marcotayar/manipulator_ws/README.md

# manipulator_ws

ROS 2 Humble workspace for a 4-DOF RRRR desktop manipulator controlled via an ESP32 (micro-ROS).

## Robot overview

| Joint | Type | Axis | Range | Hardware |
|---|---|---|---|---|
| J1 — base yaw | Continuous | Z | velocity-only (no position limit) | 360° servo |
| J2 — shoulder | Revolute | Y | ±90° | Standard servo |
| J3 — elbow | Revolute | Y | ±90° | Standard servo |
| J4 — wrist | Revolute | Y | ±90° | MG90S servo |
| Gripper | Prismatic (×2) | Y | 0–13 mm | Servo |

**Link geometry** (matches `arm_ik_2d.py`):

```
Shoulder origin:  0.09 m above ground  (base 0.07 m + turntable 0.02 m)
L1  shoulder → elbow:  0.10 m
L2  elbow → wrist:     0.09 m
L3  wrist → EE tip:    0.15 m  (gripper_base 0.03 m + fingers 0.12 m)
```

## Screenshots

| RViz simulation — 45° base yaw | Qt hardware control panel |
|:---:|:---:|
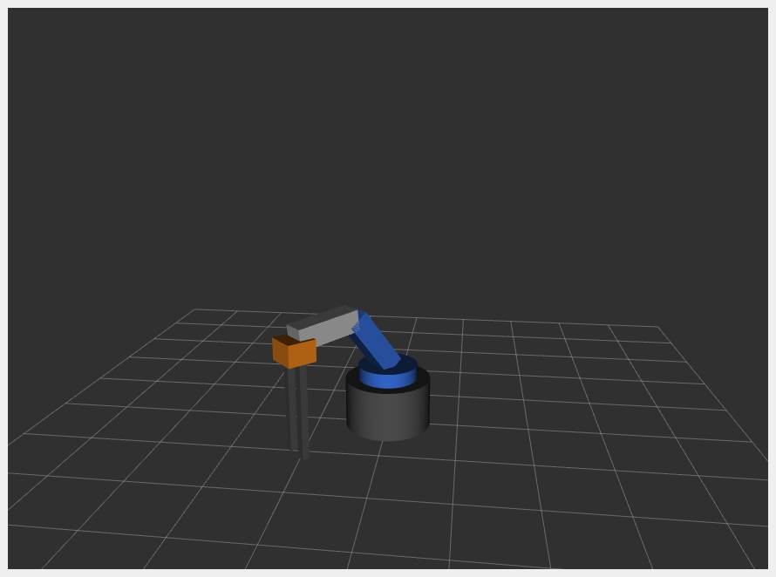
[picture p1: docs/images/rviz_simulation.png]
RRRR manipulator in RViz
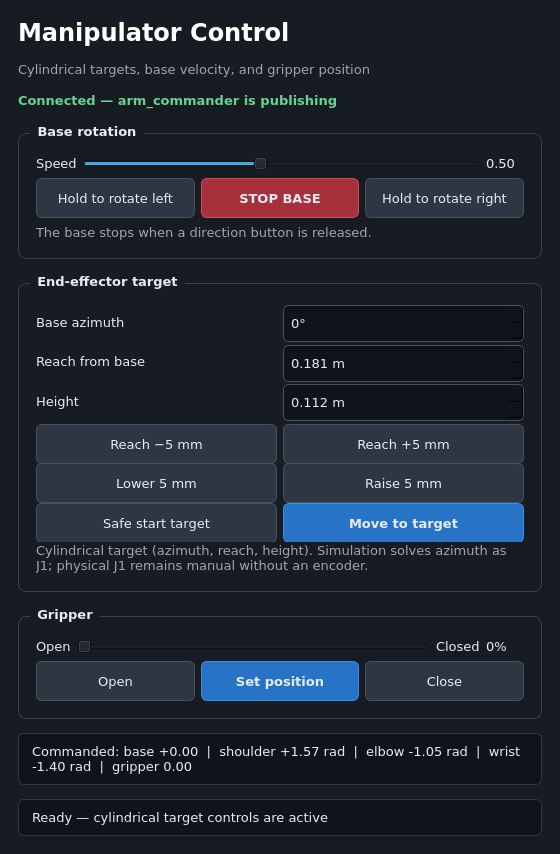
[picture p2: docs/images/qt_control_panel.png]
Qt manipulator control panel
|  |  |

## Packages

| Package | Type | Purpose |
|---|---|---|
| `manipulator_description` | ament_cmake | URDF/xacro, RViz config |
| `manipulator_control` | ament_python | Keyboard teleop, click-to-target, arm commander, 2D IK |
| `manipulator_kinematics` | ament_python | 3D IK node with TF-based trajectory visualization |

## Prerequisites

- **ROS 2 Humble**
- **setuptools 58.2.0** — required for colcon to build `ament_python` packages (newer versions dropped `setup.py develop --editable`):

```bash
pip3 install setuptools==58.2.0
```

- Standard ROS tools (already in a desktop install):

```bash
sudo apt install ros-humble-joint-state-publisher-gui \
                 ros-humble-robot-state-publisher \
                 ros-humble-rviz2 \
                 ros-humble-xacro \
                 ros-humble-tf2-ros \
                 ros-humble-joy \
                 python3-pyqt5
```

`ros-humble-joy` is only needed if you are using a gamepad.
`python3-matplotlib` and `python3-numpy` are optional dependencies for
regenerating the workspace plot.

## Build

```bash
cd ~/manipulator_ws
source /opt/ros/humble/setup.bash
colcon build --symlink-install
source install/setup.bash
```

Add the source line to your shell if you don't want to run it each session:

```bash
echo "source ~/manipulator_ws/install/setup.bash" >> ~/.bashrc
```

## Usage modes

### 1. Visualize only (joint sliders)

Shows the robot in RViz with a GUI slider for every joint. Useful for checking the model.

```bash
source /opt/ros/humble/setup.bash
source install/setup.bash
ros2 launch manipulator_description display.launch.py
```

### 2. Keyboard teleop

Opens RViz and lets you drive each joint from the keyboard. Run the launch file in one terminal and the teleop node in a second terminal (it requires raw key input on its own TTY).

**Terminal 1:**
```bash
ros2 launch manipulator_control teleop.launch.py
```

**Terminal 2:**
```bash
ros2 run manipulator_control keyboard_teleop
```

Key bindings:

| Key | Action |
|---|---|
| `q` / `a` | base spin left / right (velocity, keeps spinning) |
| `space` | base stop |
| `w` / `s` | J2 shoulder +/− |
| `e` / `d` | J3 elbow +/− |
| `r` / `f` | J4 wrist +/− |
| `t` / `g` | gripper close / open |
| `z` | home (all joints to 0, base stops) |
| `x` | quit |

J1 is velocity-controlled: press `q` or `a` to start spinning, `space` to stop. J2–J4 step 0.05 rad (~3°) per keypress; gripper steps 2 mm.

### 3. Click-to-move (IK)

Click anywhere in the RViz viewport to send the arm to that position using the IK solver. The EE trajectory is drawn as an orange line.

```bash
ros2 launch manipulator_control click_move.launch.py
```

In RViz, select the **Publish Point** tool from the top toolbar, then click on the ground grid. The IK node smoothly interpolates the arm to the target over ~1.5 s and reports the final position error in the terminal.

### 4. Base + gripper teleop (separate node)

Velocity control for the continuous-rotation base servo and direct gripper control:

```bash
ros2 run manipulator_control base_gripper_teleop
```

| Key | Action |
|---|---|
| `j` | base rotate left |
| `l` | base rotate right |
| `k` | base stop |
| `o` | gripper open |
| `p` | gripper close |
| `x` | quit |

### 5. Real hardware (joystick + click-to-target)

See [Hardware control](#hardware-control) below.

### 6. Qt panel (real hardware) and RViz simulation

```bash
ros2 launch manipulator_control sim.launch.py             # test IK in RViz, kinematic plant
ros2 launch manipulator_control sim.launch.py plant:=pid  # closed-loop PID plant (section 7)
ros2 launch manipulator_control hardware.launch.py        # Qt panel for full_arm_controller
```

The simulation launches start RViz, click-to-target and `arm_commander`. The Qt
panel (`arm_control_gui`) is hardware-only: it talks to `full_arm_controller`
over `/arm_joint_targets_deg`, `/arm_pid_enable`, `/arm_pid_gains`,
`/arm_joint_telemetry` and `/estop`.

- **Tuning tab:** per-joint enable, target slider, Kp/Ki/Kd/G (sent only while
  every joint is disabled; defaults mirror the firmware), and live plots of
  angle, target and motor duty. Fault code and joint are shown in the header.
- **Inverse kinematics tab:** click the side view to set a goal for the gripper
  tip; the tip angle is chosen automatically or set with the slider. With all
  three joints enabled, **Move along straight line** streams intermediate IK
  solutions at 20 Hz (3 cm/s, every joint capped at 6°/s, under the firmware's
  8°/s ramp). If the straight line would cross a joint limit, the move finishes
  in joint space and the panel says so.
- **Safety:** targets are seeded from the first telemetry sample and disabled
  joints keep tracking their measured angle, so enabling never jumps.
  **Park at 90° & disable** brings every enabled joint to vertical before
  cutting power (a disabled joint far from vertical falls); **Disable now** cuts
  power immediately.

Kinematics (`arm_kinematics.py`) use the firmware's physical degrees: 90° is a
link straight up, larger angles lean outward, and each joint's lean adds to the
links before it. Targets are limited to 85–175° (wrist 85–170°).

For calibrated shoulder feedback and isolated shoulder PID control, use
`shoulder_pot_feedback/shoulder_pot_feedback.ino`.
Copy `shoulder_pot_feedback/wifi_config.example.h` to `wifi_config.h` in that
directory, then set the Wi-Fi credentials and `AGENT_IP` to the computer's current
Wi-Fi IPv4 address. `wifi_config.h` is ignored by Git; never commit credentials.
The address can change after reconnecting to a hotspot. Keep the micro-ROS agent
running on UDP port 8888. Check `ros2 topic hz /shoulder_feedback`: expect about
20 Hz. The potentiometer wiper must reach GPIO34 through a suitable voltage
divider, with a shared ground; never exceed the ESP32 ADC input voltage.
The installed divider uses the measured descending-sweep calibration below.
Firmware interpolates between adjacent anchors and clamps feedback to 0–75°.

| Shoulder angle from horizontal | Raw ADC median |
|---|---|
| 0° | 2319 |
| 15° | 2525 |
| 30° | 2687 |
| 45° | 2874 |
| 60° | 3037 |
| 75° | 3100 |

At 90° the raw median was 3101, indistinguishable from 75° within measured noise.
Consequently, feedback cannot identify motion above 75°; 75° is a saturation
value, not proof of the physical angle. Sensitivity is lower near the upper end.
An ascending 45° check gave ADC 2865 (44.28° with this mapping). This is a held-point
calibration, not an independently validated full-travel accuracy specification.
Recalibrate `SHOULDER_CALIBRATION` after changing the divider or wiring, using
`CALIBRATE_MODE 1` to read raw ADC over USB at 115200 baud.
Measured shoulder feedback is displayed without the commanded-motion 10° lower
limit; command limits are unchanged.

#### Full-arm H-bridge wiring and calibration

`docs/ligacao_pontes_h_esp32.pdf` shows the original two-TB6612 layout; the arm
is now wired as below (verified by single-joint motor tests):

| Joint | Driver channel | PWM | IN1 | IN2 | Potentiometer | `direction` |
|---|---|---:|---:|---:|---:|---:|
| Shoulder | TB6612 #1 A | GPIO19 | GPIO18 | GPIO5 | GPIO34 | +1 |
| Base (DC motor, no feedback) | TB6612 #1 B | GPIO17 | GPIO16 | GPIO15 | — | held LOW |
| Elbow | TB6612 #2 A | GPIO23 | GPIO22 | GPIO21 | GPIO39 | −1 |
| Wrist | TB6612 #2 B | GPIO32 | GPIO14 | GPIO13 | GPIO36 | +1 |
| Gripper, positional servo | Direct servo signal | GPIO26 | — | — | — | — |

The base motor is not controlled yet: firmware drives GPIO17/16/15 LOW from boot.

GPIO4 drives both TB6612 STBY inputs wired together. Both bridges use ESP32
3V3 for logic VCC, an external motor-rated VM supply, and a common ground.
GPIO34, GPIO36, and GPIO39 are ADC1 input-only pins and remain usable while
Wi-Fi is active. Each potentiometer is supplied from ESP32 3V3 with a common
ground, and its wiper connects directly to its ADC pin.
GPIO5 and GPIO15 are ESP32 strapping pins; if the ESP32 does not boot reliably,
disconnect those driver inputs before power-up and move them in both the wiring
and firmware before deployment.

`full_arm_controller/full_arm_controller.ino` is the full-arm controller for this
wiring: position PID for shoulder, elbow, and wrist plus base and gripper servo
outputs. Copy `wifi_config.example.h` to `wifi_config.h` in that directory (ignored
by Git) and set `AGENT_IP` to the computer's address on the same 2.4 GHz network.
The ESP32 cannot join WPA2-Enterprise networks such as eduroam.

```bash
docker run --rm --net=host microros/micro-ros-agent:humble udp4 --port 8888
arduino-cli compile --fqbn esp32:esp32:esp32 full_arm_controller
```

Joint angles are **physical** degrees with 90° as the home pose (arm vertical),
not the `arm_ik_2d.py` frame. Commands are limited to 85–175°.

> **The arm falls on any fault or disable.** Every fault (stale target,
> invalid feedback, stall, runaway, e-stop) and every ordinary disable
> short-brakes all motors (TB6612 IN1 = IN2 = HIGH). Braking slows a falling
> link but the motors cannot hold position unpowered:
> the shoulder sagged from 110° and then fell past its 180° stop, saturating
> GPIO34 (above 3.3 V). Keep the arm mechanically supported whenever it is away
> from vertical, and bring joints back near 90° before disabling.

| Topic | Type | Meaning |
|---|---|---|
| `/arm_joint_targets_deg` | `std_msgs/Float32MultiArray` | Exactly `[shoulder, elbow, wrist]`, 85–175°, refreshed within 1 s |
| `/arm_pid_enable` | `std_msgs/Int32` | Bitmask: 1 shoulder, 2 elbow, 4 wrist; 0 disables all; boots disabled |
| `/arm_pid_gains` | `std_msgs/Float32MultiArray` | 15 values `[Kp,Ki,Kd,G,F]` × shoulder/elbow/wrist; only while all disabled. `G` = gravity feedforward, 0–80% duty with the link horizontal. `F` = friction feedforward, 0–40% duty in the direction the setpoint moves (full at 2°/s, zero at rest); defaults 10/12/10. The 1.5° deadband applies only after the target has been still for 0.3 s |
| `/estop` | `std_msgs/Bool` | Transient-local; true disables all joints |
| `/arm_command` | `std_msgs/Float32MultiArray` | Only `[4]` gripper is used |
| `/arm_joint_telemetry` | `std_msgs/Float32MultiArray` | 20 Hz, 16 values (below) |

Telemetry: `[shoulder_deg, elbow_deg, wrist_deg, shoulder_raw, elbow_raw,
wrist_raw, shoulder_target, elbow_target, wrist_target, shoulder_duty,
elbow_duty, wrist_duty, enabled_mask, fault_code, fault_joint, estop]`. Angles are
−1 outside the calibration table. Fault codes: 0 none, 1 invalid/stale target,
2 feedback invalid or outside 80–178°, 3 control timeout, 4 e-stop, 5 runaway
(joint moved more than 4° opposite to the applied push, away from its commanded
target, and is more than 6° (shoulder, elbow) or 10° (wrist) from it, confirmed on two consecutive 20 Hz control
samples; a joint carried toward its target while the controller brakes is fine).
Zero output does not reset the direction reference; a genuine reversal does.
On a runaway fault, USB serial records the triggering raw ADC, measured angle,
target, ramp setpoint, output and reference after braking all joints.
6 stall (output at
the duty cap for 1 s with under 1° of motion; protects the TB6612). Any fault
disables every joint. Targets are followed through an internal 8°/s ramp that
stays within 6° of the measured angle, so large target jumps do not slam the
joint. Output is capped at 80% duty; the 1 s stall cutout limits time at the cap.
Inside the 1.5°
deadband the controller stops correcting but keeps applying its frozen integral,
so gravity-loaded joints hold instead of falling. Control runs in a dedicated
20 Hz FreeRTOS task, independent of Wi-Fi/micro-ROS stalls.

**Gravity compensation:** each joint adds `-G · sin(lean)` duty, where `lean` is
the sum of `(angle − 90°)` from the shoulder out to that joint (how far its
distal links lean from vertical). This assumes all three joints increase their
angle in the same rotational sense. A joint gets no feedforward if any reading
from the shoulder out to it is invalid. Defaults come from powered holds at 135°
(G = hold duty minus the P correction, over sin(lean)): shoulder 33, elbow 28
(held 137.0° with 0.02° drift over 8 s), wrist 25. The wrist needs its term once
the shoulder leans; with `G = 0` it was dragged outward during a shoulder move.
The prebuilt micro-ROS library allows at most 5 subscriptions, so `G` shares the
gains message instead of having its own topic.

**Commissioning results:** all three directions are verified. Shoulder (Kp 2.0,
Ki 0.3) and wrist (Kp 4.0, Ki 1.0) reach a 5° step; both need about 10–22% duty
to break static friction and stick about 2° past the target. The elbow (Kp 4.0,
Ki 1.0) did not move at all at the 50% cap (stall). Do not raise its cap: MG996R stall
current exceeds the TB6612's 1.2 A continuous rating. Check VM under load and
the elbow's mechanical load first. Enable one joint at a time.

```bash
ros2 topic pub --rate 10 /arm_joint_targets_deg std_msgs/msg/Float32MultiArray "{data: [90.0, 90.0, 90.0]}"
ros2 topic pub --once /arm_pid_enable std_msgs/msg/Int32 "{data: 1}"   # shoulder only
ros2 topic pub --once /arm_pid_enable std_msgs/msg/Int32 "{data: 0}"   # disable all
```

Calibration tables (`full_arm_controller/*_calibration_*.csv`) belong only to the
current potentiometers, ADC pins, mounting, and direct-wiper wiring. Shoulder
values are midpoints of ascending and descending passes; expect about ±3°
(direction-dependent play). Set `CALIBRATE_MODE 1` to print raw ADC CSV over USB
with every actuator disabled and Wi-Fi off. Never copy one joint's table to
another or reuse it after rewiring.

#### Shoulder PID position control (TB6612FNG HW166)
> **Legacy shoulder-only wiring:** this section documents the previously tested
> standalone shoulder setup. Its GPIO32/14/13/25/26/27 outputs conflict with the
> updated full-arm wiring above. Do not flash `shoulder_pot_feedback.ino` while
> the two bridges are wired according to `ligacao_pontes_h_esp32.pdf`.

The shoulder is a two-wire DC motor driven by channel B, not a PWM-position servo.
The standalone sketch retains GPIO34 potentiometer feedback.

| Driver terminal | Connection |
|---|---|
| PWMB | ESP32 GPIO32 |
| BIN1 / BIN2 | ESP32 GPIO14 / GPIO13 |
| STBY | ESP32 GPIO25 |
| AIN1 / AIN2 | ESP32 GPIO26 / GPIO27 (held low; channel A unused) |
| BO1 / BO2 | Shoulder motor leads |
| VCC | ESP32 3V3 (logic supply) |
| VM | Motor's rated external supply |
| GND | ESP32 GND and external supply negative |

VCC is separate from VM. At 5 V logic supply, the driver's guaranteed input-high
threshold exceeds the ESP32's 3.3 V output; use 3.3 V for VCC. Check the motor's
stall current against the driver/module rating before powering it.
See the [TB6612FNG datasheet](https://www.pololu.com/file/0J86/TB6612FNG.pdf).

`shoulder_pot_feedback/shoulder_pot_feedback.ino` runs a 20 Hz position PID on
the ESP32 using the measured potentiometer calibration. Positive duty raises
the shoulder; negative duty lowers it. Channel B uses 20 kHz PWM.
The open-loop duty topic is removed: the PC sends a position target, not power.

| Topic | Type | Meaning |
|---|---|---|
| `/shoulder_target_deg` | `std_msgs/Float32` | Finite target in degrees from horizontal, 5–70° |
| `/shoulder_pid_enable` | `std_msgs/Bool` | Explicit enable/disable; disabled at boot |
| `/shoulder_feedback` | `std_msgs/Float32` | Measured angle in radians, unchanged |
| `/estop` | `std_msgs/Bool` | Transient-local safety subscription; true disables PID |
| `/shoulder_pid_gains` | `std_msgs/Float32MultiArray` | Exactly `[Kp, Ki, Kd]`; accepted only disabled and not estopped |
| `/shoulder_pid_telemetry` | `std_msgs/Float32MultiArray` | Firmware diagnostics at 20 Hz; schema below |

Targets must be refreshed within 1 second. Enabling requires a fresh valid target
and a valid measurement less than 150 ms old. Invalid targets, out-of-calibration
ADC readings, measured angles outside 5–70°, stale targets/control updates, and
initialization errors disable PID and enter standby. E-stop release never
re-enables it: send a fresh target and explicitly enable again.
These are software checks, not a hardware safety cutoff; standby coasts and
does **not** hold the arm against gravity. Keep the arm supported and motor power
accessible during commissioning. Sensor saturation above 75° is not recoverable.

Initial, **not hardware-tuned**, gains are `PID_KP=0.6`, `PID_KI=0.1`,
`PID_KD=0.04`, with degrees as the error unit and duty percent as the output unit.
Output is limited to ±15%. The controller uses measured elapsed time,
derivative on measurement with a 0.1 s velocity low-pass filter, and conditional
integration anti-windup. No minimum-duty kick or gravity compensation is assumed.
It may respond slowly, stall or oscillate until tuned for the actual load.

**Graphical tuning:** the Qt panel (`hardware.launch.py`) drives
`full_arm_controller`, not this single-joint sketch. Tune this sketch with the
topics above.

Gain ranges are Kp 0–5, Ki 0–2, Kd 0–1 (finite values only). The ±15% output
limit is not raised by gain changes. Live tuning means monitoring the response
and adjusting gains between disabled runs, not changing gains during motion.

Telemetry has exactly 14 values:
`[target_deg, measured_deg, error_deg, P_duty, I_duty, D_duty, output_duty,
enabled, estop, Kp, Ki, Kd, max_duty, fault_code]`.
Duty quantities are percentages; enabled/estop are 0 or 1. Fault codes:
0 none, 1 invalid/stale target, 2 invalid/out-of-safe-range feedback,
3 control timeout, 4 emergency stop. Disabled output and P/I/D terms are zero.

Build only (does not upload or move hardware):

```bash
arduino-cli compile --fqbn esp32:esp32:esp32 shoulder_pot_feedback
```

After a separate, supervised upload/commissioning step, start a continuous target
publisher at the arm's current safe measured angle. Example for an arm at 45°:

```bash
ros2 topic pub --rate 10 /shoulder_target_deg std_msgs/msg/Float32 "{data: 45.0}"
```

In another terminal, explicitly enable:

```bash
ros2 topic pub --once /shoulder_pid_enable std_msgs/msg/Bool "{data: true}"
```

Disable while continuing to support the arm:

```bash
ros2 topic pub --once /shoulder_pid_enable std_msgs/msg/Bool "{data: false}"
```

Stopping the target publisher also disables control after the one-second timeout.
The panel's existing IK position controls and `/arm_command` do not feed this
isolated shoulder controller; use its Shoulder PID tab or the direct topics.
The panel's `/estop` also disables the shoulder PID. The all-servo
`esp32_microros.ino` is a different hardware configuration and must not be flashed
on this TB6612 wiring: its output pins conflict with the driver connections.

**Emergency stop.** The red button publishes a latched `/estop`
(`std_msgs/Bool`). While engaged, `arm_commander` and `ik_node` stop the base,
freeze the arm at its last command and ignore new targets, base and gripper
commands; the panel's controls are disabled. Click again to release. It stops
only what goes through these nodes; it does not cut servo power.

Hold a base direction button to rotate; releasing it sends a stop command.
The reach/height jog buttons move in 5 mm steps, and invalid targets are
rejected in the panel. The status line turns green when `/arm_command`
feedback is being received from `arm_commander`.

Analysis window (read-only, run next to either launch):

```bash
ros2 launch manipulator_control analysis.launch.py
```

It plots tracking error (command − measured, per joint) and the gripper and
base signals, with pause/resume, clear, a 10/20/60 s window and CSV export of
the full recording (up to one hour). Without an elbow/wrist sensor on hardware
only the shoulder error is available.

### 7. Closed-loop PID numerical simulation

`sim.launch.py plant:=pid` runs the same panel and `/arm_command`
interface as deployment, but replaces
the ESP32/servos with a 200 Hz numerical plant. J2-J4 use position PID with
gravity feedforward; J1 uses velocity PID; the gripper uses position PID.
`/joint_states` contains simulated encoder measurements, not copied commands.

Desired state is published on `/joint_setpoint`. `/pid_diagnostics` contains
five errors followed by five controller efforts. Publish five additive efforts
to `/sim_disturbance` to test rejection, then publish zeros to remove them:

```bash
ros2 topic pub -1 /sim_disturbance std_msgs/msg/Float32MultiArray \
  "{data: [0.0, 0.25, 0.0, 0.0, 0.0]}"
ros2 topic pub -1 /sim_disturbance std_msgs/msg/Float32MultiArray \
  "{data: [0.0, 0.0, 0.0, 0.0, 0.0]}"
```

The inertia, damping, and PID gains in `pid_sim_node.py` are nominal simulation
parameters. Identify the real plant after installing encoders before reusing
those gains on hardware.

## ROS topics

| Topic | Type | Publisher | Subscriber |
|---|---|---|---|
| `/joint_states` | `sensor_msgs/JointState` | `keyboard_teleop`, `ik_node`, or `pid_sim` | `robot_state_publisher` |
| `/joint_setpoint` | `sensor_msgs/JointState` | `pid_sim` | diagnostics/plots |
| `/target_pose` | `geometry_msgs/Point` | `click_to_target`, `joy_to_arm` | `ik_node`, `arm_commander` |
| `/base_cmd` | `std_msgs/Float32` | `joy_to_arm`, `base_vel_gui`, `base_gripper_teleop`, `keyboard_teleop` | `arm_commander`, `ik_node` |
| `/gripper_cmd` | `std_msgs/Float32` | `joy_to_arm`, `base_gripper_teleop` | `arm_commander`, `ik_node` |
| `/estop` | `std_msgs/Bool` (latched) | `arm_control_gui` | `arm_commander`, `ik_node`, `full_arm_controller` |
| `/joy` | `sensor_msgs/Joy` | `joy_node` | `joy_to_arm` |
| `/arm_command` | `std_msgs/Float32MultiArray` | `arm_commander` | ESP32 (micro-ROS), `pid_sim` |
| `/pid_diagnostics` | `std_msgs/Float32MultiArray` | `pid_sim` | diagnostics/plots |
| `/sim_disturbance` | `std_msgs/Float32MultiArray` | test/operator | `pid_sim` |
| `/clicked_point` | `geometry_msgs/PointStamped` | RViz | `click_to_target` |
| `/click_marker` | `visualization_msgs/Marker` | `click_to_target` | RViz |
| `/ee_trajectory` | `visualization_msgs/Marker` | `ik_node` | RViz |

### `/arm_command` payload

Five floats sent to the ESP32 at 50 Hz:

```
[0]  base_velocity   -1.0 .. +1.0
[1]  shoulder_angle  rad
[2]  elbow_angle     rad
[3]  wrist_angle     rad
[4]  gripper         0.0 open .. 1.0 closed
```

The base joint uses velocity (not position) because the hardware is a continuous-rotation servo with no angle feedback.

### Action space and workspace

The physical command action is:

| Index | Action | Range |
|---:|---|---|
| 0 | Base velocity | −1.0 to +1.0 normalized |
| 1 | Shoulder angle | +0.175 to +1.571 rad (10° to 90°) |
| 2 | Elbow angle | −1.396 to +1.396 rad (−80° to 80°) |
| 3 | Wrist angle | −1.396 to +1.396 rad (−80° to 80°) |
| 4 | Gripper position | 0.0 open to 1.0 closed |

`arm_commander` prints these ranges at startup. The plot below samples the
joint limits, filters out points below ground, and revolves the planar set
through the continuous base yaw. It does not model self-collision or payload.

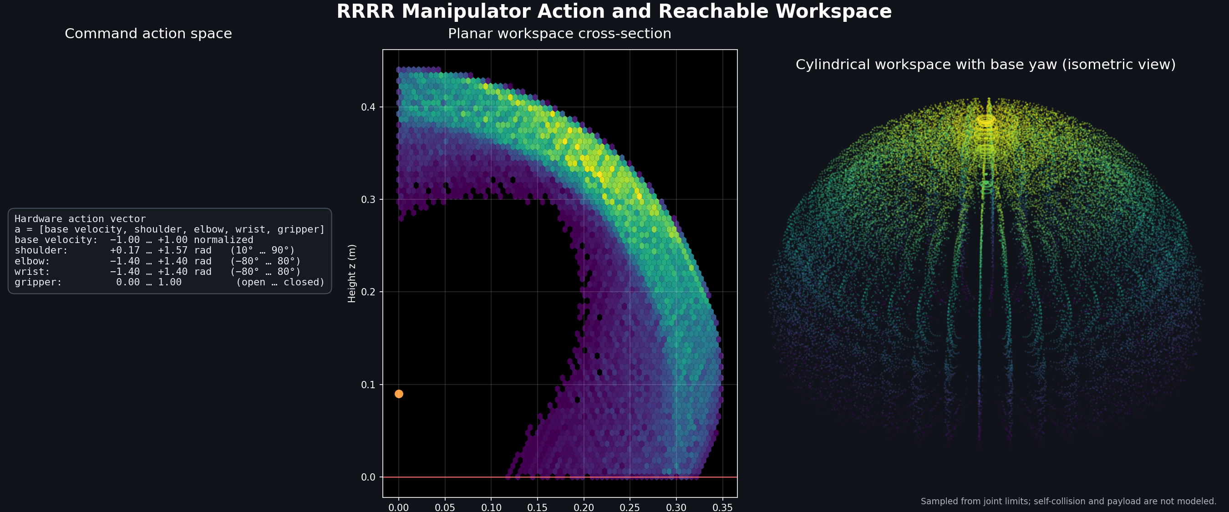
[picture p3: docs/images/action_space.png]
Manipulator action and reachable workspace


Regenerate the plot with:

```bash
python3 src/manipulator_control/scripts/plot_action_space.py
```

## IK solvers

Two independent IK implementations are included:

**`arm_ik_2d.py`** (used by `arm_commander`) — cylindrical decomposition plus
2D geometric IK in the vertical arm plane. It converts a Cartesian target with
`yaw = atan2(y, x)` and `reach = sqrt(x² + y²)`, then solves shoulder, elbow,
and wrist. It prefers the EE pointing straight down and searches other
orientations in 1° steps when necessary.

**`ik_node.py`** (used by `click_move.launch.py`) — full cylindrical IK for the
simulation. It commands J1 to the solved yaw, interpolates all four joints over
50 steps, and reads the EE position from TF for trajectory drawing.

#### Why hardware base yaw remains manual

The cylindrical solver returns an absolute base yaw, and the URDF simulation
uses it directly. The physical J1 is a 360° continuous-rotation servo: it only
accepts speed and has no encoder, so the software cannot know its current angle
or close the loop on a desired yaw. The Qt azimuth field is therefore a target
reference for hardware while the operator aligns J1 with the hold buttons.

For true four-joint hardware IK, replace J1 with a positional servo or add an
absolute encoder. Then `/arm_command[0]` can carry base yaw instead of velocity
and the firmware can close the position loop.

## Hardware control

The gamepad connects to the **PC** (USB or Bluetooth), not to the ESP32. The ESP32 only runs a lightweight micro-ROS subscriber and drives the servos.

```
Gamepad ──(USB/BT)──▶ PC
                       ├─ joy_node      → /joy
                       ├─ joy_to_arm    → /base_cmd, /target_pose, /gripper_cmd
                       └─ arm_commander → /arm_command ──(WiFi)──▶ ESP32 servos
```

Arduino libraries required: **ESP32Servo**, **micro_ros_arduino** (Humble branch).

---

### One-time firmware setup

**1. Fill in your network details** at the top of `esp32_microros.ino`:

```cpp
#define WIFI_SSID   "your-network"
#define WIFI_PASS   "your-password"
#define AGENT_IP    "192.168.x.x"   // run: hostname -I | awk '{print $1}'
#define AGENT_PORT  8888
```

**2. Flash** via Arduino IDE (board: *ESP32 Dev Module*, partition scheme: *Huge APP (3MB No OTA)*, upload speed: 921600).

**3. Verify servo zero positions** — at startup all servos receive 1500 µs (center pulse). The arm should sit with each link pointing **horizontal** (shoulder/elbow/wrist all at 0 rad in `arm_ik_2d` convention). If a link points the wrong way, rotate the servo horn one spline and reflash.

---

### Every session

**Terminal 1 — micro-ROS agent** (keep running):

```bash
docker run -it --rm --net=host microros/micro-ros-agent:humble udp4 --port 8888
```

Wait for `[1] [RTPS Participant matched]` — confirms the ESP32 connected.

**Terminal 2 — joystick driver:**

```bash
ros2 run joy joy_node
```

Plug in or pair your gamepad before running this. Verify it works with `ros2 topic echo /joy`.

**Terminal 3 — joy_to_arm translator:**

```bash
source ~/manipulator_ws/install/setup.bash
ros2 run manipulator_control joy_to_arm
```

**Terminal 4 — arm_commander** (IK + hardware bridge):

```bash
ros2 run manipulator_control arm_commander
```

---

### Gamepad button mapping

| Input | Action |
|---|---|
| **L1** | Base rotate left |
| **R1** | Base rotate right |
| **D-pad ↑ / ↓** | EE height +/− 5 mm |
| **D-pad → / ←** | EE reach +/− 5 mm |
| **△ / Y** | Gripper open |
| **□ / X** | Gripper close |

Default indices are set for **PS3/PS4 on Linux**. If your controller maps differently, run `ros2 topic echo /joy` while pressing buttons to find the right indices, then edit the constants at the top of [joy_to_arm.py](src/manipulator_control/manipulator_control/joy_to_arm.py).

**Reachable workspace** (ground-level targets, with wrist orientation allowed
to tilt when straight-down is unavailable):

```
approximately 0.120 m ≤ reach from base axis ≤ 0.324 m
```

The UI input bounds are intentionally broader; the IK solver validates every
reach/height pair and rejects targets outside the actual joint-limited region.

---

### Failsafe behaviour

| Condition | Response |
|---|---|
| `/arm_command` silent for > 1 s | Base servo stops; position servos hold last angle |
| micro-ROS agent unreachable for > 5 s | ESP32 reboots and reconnects automatically |

> **Note:** RViz shows the URDF at its home pose and does not mirror the real arm. `arm_commander` does not publish `/joint_states`.

---

### Calibration

**Joystick feel** — edit constants at the top of [joy_to_arm.py](src/manipulator_control/manipulator_control/joy_to_arm.py):

| Constant | Default | Adjust when… |
|---|---|---|
| `STEP` | 0.005 m | D-pad steps feel too coarse or too fine |
| `BASE_SPEED` | 0.5 rad/s | Base rotates too fast or too slow |

**Servo tuning** — edit constants at the top of `esp32_microros.ino`:

| Constant | Default | Adjust when… |
|---|---|---|
| `BASE_SPEED_RANGE` | 200 µs | Base doesn't reach the speed set by `BASE_SPEED` |
| `GRIP_OPEN_DEG` | 80° | Gripper does not open to the desired position |
| `GRIP_CLOSED_DEG` | 140° | Gripper does not close to the desired position |
| `SERVO_MIN_US` / `SERVO_MAX_US` | 500 / 2500 µs | Positional servo travel is compressed or reaches its mechanical stop |
