marcotayar/manipulator_ws/docs/manipulator_modeling_pid.pdf

## Mathematical Modeling and Closed-Loop PID Control

Four-DOF RRRR Desktop Manipulator with Positional Gripper

ROS 2 Humble implementation: manipulator_ws

September 2026

Abstract

This document derives the kinematic and numerical dynamic models implemented in the ROS 2 workspace, then derives the discrete PID controllers used by the closed-loop simulator. It distinguishes model parameters from experimentally identified hardware data, defines every coordinate conversion and ROS interface, and gives a direct path from simulated encoder feedback to encoder-based hardware deployment. The implementation referenced throughout is the PID simulation node; geometry and inverse kinematics are shared with the manipulator control package.

Scope. The current closed-loop simulator is a deliberately compact numerical plant, not a full multibody or finite-element model. It includes nominal inertia, viscous damping, gravity, effort saturation, hard stops, disturbances, and simulated encoder states. Parameters marked nominal must be identified on the real arm before gains are transferred to hardware.

### Contents

1 Robot definition | 2
2 Coordinate conventions and forward kinematics | 3
3 Inverse kinematics | 4
4 Numerical dynamic plant | 4
5 PID controller derivation | 5

RRRR Manipulator | Mathematical Model and PID Control
6 Closed-loop interpretation | 7
7 ROS 2 signal model | 7
8 Numerical validation results | 7
9 Encoder-based hardware deployment | 8
10 Model limitations and interpretation | 9
11 Source-to-equation traceability | 10

### 1 Robot definition

### 1.1 Generalized coordinates

The robot has one base-yaw joint and three serial pitch joints:

q =

h
q1 | q2 | q3 | q4

iT

The URDF convention used by the numerical plant is:

- q1: rotation about world +z; continuous.
- q2, q3, q4: rotation about each local +y axis.
- At q2 = q3 = q4 = 0, all arm links point along +z.
- Positive pitch rotates a link from +z toward the radial +x direction.

The gripper has two mirrored prismatic joints. Both receive the same joint coordinate; opposite URDF axis vectors create symmetric finger motion.

### 1.2 Geometry

Table 1: Geometry used by URDF, FK, IK, and PID simulation.
Symbol Meaning | Value
h0 | shoulder height above ground | 0.090 m
L1 | shoulder to elbow | 0.100 m
L2 | elbow to wrist | 0.090 m
L3 | wrist to end-effector tip | 0.160 m
rb | base radius | 0.060 m
hb | base-cylinder height | 0.070 m
wl
, dl | link cross-section | 0.030 × 0.030 m
sf | finger travel per side | 0.030 m

The nominal geometric reach is
| L1 + L2 + L3 = 0.350 m,

but the usable workspace is smaller and non-convex because of joint limits, ground clearance, and end-effector orientation feasibility.

### 1.3 Masses and URDF inertias

Component | Mass (kg)
Base | 0.150
Turntable | 0.030
Link 1 | 0.095
Link 2 | 0.095
Gripper parameter | 0.080
Each finger | 0.010

For a uniform box of side lengths (a, b, c), the URDF uses

Ixx =

m
(b

2 + c

2
), Iyy =

m
(a

2 + c

2
), Izz =

m
(a

2 + b

2
).

For a solid cylinder of radius r and height h,

Ixx = Iyy =

m
12

(3r

2 + h

2
), Izz =

1
2

mr²

These URDF values describe individual visual links. The compact PID plant uses separate effective diagonal joint inertias listed in Section 4.

### 1.4 Limits and command space

The URDF permits q2, q3, q4 ∈ [−90◦

, 90◦
]. Hardware IK applies stricter servo-safe limits in its angle-from-horizontal convention:

10◦ ≤ α2 ≤ 90◦
,
−80◦ ≤ α3 ≤ 80◦
,
−80◦ ≤ α4 ≤ 80◦

The deployment vector on /arm_command is

a =

h
ub | α2 | α3 | α4 | cg

iT
,

where ub ∈ [−1, 1] is normalized base velocity and cg ∈ [0, 1] is normalized gripper closure (0 open, 1 closed).

### 2 Coordinate conventions and forward kinematics

### 2.1 Hardware-to-URDF conversion

Hardware IK measures arm angles from the horizontal plane, while the URDF measures pitch from vertical. The exact conversion implemented by the simulator is

q2 =

π
2
− α2, | q3 = −α3, | q4 = −α4. | (1)

This conversion has been checked by substituting solved configurations into the URDF forward kinematics; tested Cartesian residuals were below displayed floating-point precision (0.000 mm).

### 2.2 Planar forward kinematics

Define cumulative pitch angles

θ2 = q2, | θ3 = q2 + q3, | θ4 = q2 + q3 + q4.

The radial reach and tip height are

r(q) = L1 sin θ2 + L2 sin θ3 + L3 sin θ4, | (2)
z(q) = h0 + L1 cos θ2 + L2 cos θ3 + L3 cos θ4. | (3)

Base yaw revolves the planar chain around the world z axis:

x = r cos q1, | y = r sin q1, | z = z(q). | (4)

Thus the Cartesian target is decomposed cylindrically as

q

⋆
1 = atan2(y

⋆

, x⋆

), r⋆ =

q
(x

⋆)
2 + (y

⋆)
2.

### 3 Inverse kinematics

The deployed IK is solved in the vertical arm plane using hardware angles αi

. For a candidate
end-effector approach angle ϕ, subtract link L3 to obtain the wrist point relative to the shoulder:

wx = r

⋆ − L3 cos ϕ, | (5)

wy = z

⋆ − h0 − L3 sin ϕ, | (6)

d

2 = w

2
x + w

2
y
. | (7)

A two-link solution exists only when

|L1 − L2| ≤ d ≤ L1 + L2.

The elbow angle follows the cosine law:

cos α3 =

d

2 − L

2
1 − L

2
2
2L1L2
. | (8)

Both branches are evaluated:

α3 = ± arccos

d

2 − L

2
1 − L

2
2
2L1L2

!

Then

k1 = L1 + L2 cos α3, | (9)
k2 = L2 sin α3, | (10)
α2 = atan2(wy, wx) − atan2(k2, k1), | (11)
α4 = ϕ − (α2 + α3). | (12)

The solver tests ϕ = −90◦ first, then searches outward in 1

◦
increments through the full angular range. It rejects configurations violating servo-safe limits or z < 0. The primary cost minimizes departure from a downward-pointing end effector:

Jϕ = |ϕ + 90◦

Among equally oriented candidates, continuity is selected by

Jq = (α2 − α2,p)

2 + (α3 − α3,p)

2 + (α4 − α4,p)

2

A 10⁻⁶
rad comparison tolerance preserves mathematically on-limit poses; accepted outputs are clamped back to the hard limits, so tolerance never widens the actuator command space.

### 4 Numerical dynamic plant

### 4.1 Model structure

A general rigid manipulator obeys

M(q)q¨ + C(q, q˙)q˙ + G(q) + F(q˙) = τ + τd. | (13)

The implemented numerical plant intentionally approximates this with diagonal constant inertia, viscous damping, exact configuration-dependent gravity for lumped masses, and an external disturbance input:

Iiq¨i = τi − biq˙i − Gi(q) + τd,i. | (14)

Coriolis coupling, Coulomb friction, backlash, gearbox elasticity, electrical motor dynamics, and voltage sag are not modeled.

These are control-development values, not identified servo-shaft inertias or measured torque limits.

Table 2: Nominal simulation parameters. Joint Ii (kg m²
) bi

|τi

|max

J1 | 0.0012 0.003 | 2.2
J2 | 0.0100 0.025 | 4.8
J3 | 0.0038 0.012 | 2.2
J4 | 0.0008 0.005 | 2.2

### 4.2 Gravity model

Let m1 = m2 = 0.095 kg, mg = 0.080 kg, mf = 0.010 kg, and define the distal lumped mass

| md = mg + 2mf = 0.100 kg.

With s2 = sin q2, s23 = sin(q2 + q3) and s234 = sin(q2 + q3 + q4), the implemented gravity vector is

G1 = 0, | (15)

G2 = −g

m1L1
2

s2 + m2

| L1s2 + L2
| 2 s23 + md
| | L1s2 + L2s23 +

L3
2
s234 , | (16)

G3 = −g

m2L2
2

s23 + md

| L2s23 + L3
| 2
s234 , | (17)

G4 = −g

mdL3
2

s234
, | (18)

with g = 9.80665 m/s

2
. J1 has no gravity moment because its axis is vertical in this model.

### 4.3 Discrete integration and stops

The controller and plant run at
| ∆t = 0.005 s (200 Hz).

Semi-explicit Euler integration is used:

q˙i,k+1 = ˙qi,k + ¨qi,k∆t, | (19)
qi,k+1 = qi,k + ˙qi,k+1∆t. | (20)

Measured state is published at 50 Hz. J2–J4 have ideal hard stops at ±π/2; outward velocity is cancelled at a stop while inward motion remains possible. J1 is continuous.

### 5 PID controller derivation

### 5.1 Position loops for J2–J4

For joint i, define
| ei = q ⋆ i − qi .

The implemented controller differentiates the measurement rather than the error:

τfb,i = Kp,iei + Ki,iηi − Kd,iq˙i

. | (21)

This prevents a setpoint step from producing derivative kick. Gravity is fed forward and total effort is saturated:

τi = sat[−τmax,i,τmax,i]

(τfb,i + Gi(q)). | (22)

If the model were exact and the arm stationary at the target, ei = 0 and τi = Gi

, which cancels
gravity in Equation (14).

### 5.2 Discrete integral and anti-windup

The candidate integral state is

η˜k = sat[−ηmax,ηmax]

(ηk−1 + ek∆t).

It is accepted if the raw feedback command is unsaturated, or if the error points back toward the controllable range. Otherwise ηk = ηk−1. This conditional integration prevents continued windup while an actuator is pinned. Position-loop integral limit is 2.0 rad s.

### 5.3 Base velocity loop

The base command remains compatible with the continuous-rotation servo:

q˙

⋆
1 = 1.5 sat[−1,1](ub).

Velocity error is
ev = ˙q

⋆
1 − q˙1,

and the velocity PID is
τ1 = Kp,vev + Ki,v Z
evdt − Kd,vq¨1.

Raw measured acceleration and its filtered derivative state are

q¨

raw
1,k =

q˙1,k − q˙1,k−1
∆t
, | (23)

q¨

(m)
1,k = λq¨

(m)
1,k−1 + (1 − λ)¨q

raw
1,k , | λ = 0.95. | (24)

The simulated effort is limited to ±2.2. The low-pass derivative is essential: differentiating sampled encoder velocity directly amplifies noise and, in a discrete loop, can destabilize the base controller.

### 5.4 Gripper loop

Let cg ∈ [0, 1] be desired closure and c ∈ [0, 1] be measured simulated closure. A position PID drives the normalized plant. The corresponding finger joint coordinate is

qf = −0.03(1 − c). | | (25)

Thus c = 0 gives qf = −0.03 m and 90 mm measured finger separation (open), while c = 1 gives qf = 0 and 30 mm separation (closed).

### 5.5 Controller gains

Loop | Kp | Ki | Kd
J1 velocity | 0.035 0.080 0.0015
J2 position | 0.90 | 0.22 | 0.15
J3 position | 0.42 | 0.12 | 0.075
J4 position | 0.16 0.045 | 0.030
Gripper closure | 18.0 | 5.0 | 0.8

These gains are tuned only for the nominal plant in this document. Dimensional units depend on each simulated effort channel; they are not automatically valid PWM gains.

### 6 Closed-loop interpretation

Ignoring gravity feedforward error, integral action, and saturation, a single position axis has

Iq¨+ bq˙ = Kp(q

⋆ − q) − Kdq.˙

The closed-loop transfer function is

Q(s)
Q⋆(s)

=

Kp
Is² + (b + Kd)s + Kp
. | (26)

Equivalent second-order parameters are

ωn =

s
Kp
I

, ζ =

b + Kd
2

p
IKp

Integral action adds a pole at the origin and removes constant residual error, but reduces phase margin. Saturation, gravity variation, and the hard stops make the actual model nonlinear, so these formulas guide tuning but do not replace simulation or measurement.

### 7 ROS 2 signal model

Topic | Type | Meaning
/arm_command | Float32MultiArray | Deployment-format | setpoint
| | [ub, α2, α3, α4, cg].
/joint_states | JointState | Simulated encoder positions, velocities,
and efforts; this is measured plant state, not a copied command.
/joint_setpoint | JointState | Desired URDF position and base velocity.
/pid_diagnostics | Float32MultiArray | Five errors followed by five controller ef-
| | forts.
/sim_disturbance | Float32MultiArray | Persistent | additive | efforts
[τd1, τd2, τd3, τd4, dg]; | publish zeros to
| | remove.

The full simulation launches with:

source /opt/ros/humble/setup.bash
source install/setup.bash
ros2 launch manipulator_control pid_sim.launch.py

This launch runs Qt, arm_commander, the PID plant, click-to-target, robot_state_publisher, and RViz. It intentionally does not run ik_node, because two publishers on /joint_states would make the measured state nondeterministic.

### 8 Numerical validation results

For target (x, y, z) = (0.20, 0.00, 0.02) m, measured behavior was: A 0.25 N m shoulder disturbance applied for 0.5 s produced a 15.33◦ peak error and recovered to 0.614◦ after 4 s. Base command ub = 0.5 requested 0.750 rad/s, measured 0.750 rad/s, and stopped at 0.0001 rad/s. The gripper reached both exact endpoints.

Joint Final error Peak speed Settle within 1

◦

J1 | 0.000◦ | 0.000 rad/s | immediate
J2 | 0.488◦ | 2.733 rad/s | 3.210 s
J3 | 0.199◦ | 1.128 rad/s | 0.429 s
J4 | 0.003◦ | 0.019 rad/s | immediate

An extreme ±20 N m stress input—several times the modeled actuator limits—could not move J2–J4 beyond ±90◦ and did not produce NaN or infinite state. This validates stop invariants, not realistic recovery.

For (x, y, z) = (0.22, 0.08, 0.04) m after settling:

q

⋆
2:4 =

h

0.79758 0.53283 1.32249iT
rad,

and measured values matched to the displayed precision. RViz rendered the measured pose through robot_state_publisher.

### 9 Encoder-based hardware deployment

### 9.1 Required measurements

Each encoder sample should provide timestamped qi

. Velocity should be estimated with a filtered differentiator; a simple first-order form is

q˙raw,k =

wrap(qk − qk−1)
∆t
, | (27)
q˙k = λq˙k−1 + (1 − λ) ˙qraw,k, | (28)

with angle wrapping for continuous J1. Choose λ from measured encoder noise and sample rate. Publish hardware measurements as /joint_states.

### 9.2 Controller migration

Preserve the current setpoint and diagnostic interfaces. Replace only the numerical plant step with encoder input and actuator output:

simulation: τ → numerical plant → (q, q˙),

hardware: τ → PWM/current command → encoder (q, q˙).

There must be exactly one actuator-command owner. Do not run the PID hardware node and an open-loop ESP32 command publisher simultaneously.

### 9.3 Important limitation of hobby positional servos

Shoulder, elbow, wrist, and gripper servos already contain hidden inner position controllers. An outer ROS PID therefore forms a cascade:

outer PID → servo angle command → internal controller → motor.

The outer loop should initially be slow relative to the inner loop. Start with trajectory limiting and P-only correction, then add D and finally I only when measurements justify them. Aggressive outer gains can excite the unknown inner loop, backlash, and compliance.

For the continuous base with an encoder, use a cascaded controller. Outer yaw position generates velocity:
q˙

⋆
1 = sat[−ωmax,ωmax]

(Kp,θ wrap(q

⋆
1 − q1)),

and the inner velocity PID generates the normalized servo command. Wrapping is essential near ±π:

wrap(δ) = atan2(sin δ, cos δ).

### 9.4 Identification and tuning sequence

1. Calibrate encoder zero, sign, wrap, sample timing, and missing-data behavior.
2. Measure J1 neutral pulse and velocity versus PWM offset in both directions.
3. Apply small safe steps and log setpoint, encoder position, velocity, and PWM.
4. Estimate delay, deadband, steady speed, damping, and gravity/load dependence.
5. Replace nominal Ii

, bi and actuator limits with identified values.
6. Tune P first at low payload; increase until responsive but non-oscillatory.
7. Add D using filtered measured velocity to control overshoot.
8. Add small I only to remove persistent bias; retain anti-windup.
9. Validate at joint limits, supply-voltage extremes, maximum payload, and stale feedback.
10. Require a hardware watchdog that stops J1 and freezes safe position commands when encoder or ROS commands are stale.

### 10 Model limitations and interpretation

- The diagonal inertia approximation neglects configuration-dependent mass matrix and Coriolis coupling.
- Centers of mass are idealized at link midpoints; wiring, servo bodies, horns, fasteners, and payload are not identified.
- Effort units are numerical torque-like units; hobby-servo PWM is not torque.
- Gravity feedforward uses the same approximate model as the plant, so its nominal steady-state result is intentionally optimistic.
- The 1-degree IK orientation search can make workspace feasibility granular near boundaries.
- There is no collision, table contact, Coulomb friction, stiction, backlash, thermal limit, current limit, voltage sag, or communications jitter model.
- Numerical gains demonstrate controller structure and behavior. They are not safe hardware gains without encoder calibration and plant identification.

### 11 Source-to-equation traceability

Source | | Mathematical responsibility
arm_ik_2d.py | | Geometry, limits, cylindrical conversion, FK/IK,
| | approach-angle search, continuity selection.
pid_sim_node.py: | PID.update | Equation (21), integral clamp, derivative-on-
| | measurement, conditional anti-windup.
pid_sim_node.py: | gravity_torque | Implemented G(q).
pid_sim_node.py: | timer_cb | Equations (22) and (14), Euler integration, satu-
| | ration, hard stops.
manipulator.urdf.xacro | Link dimensions, masses, link inertias, axes, and
| | joint limits.
arm_commander.py | | Target-to-IK conversion and 50 Hz deployment
| | vector.
pid_sim.launch.py | | Single-owner closed-loop simulation topology.

### Conclusion

The implemented simulator is a useful intermediate step between direct kinematic visualization and encoder-controlled hardware. Its central invariant is that setpoint and measurement are separate: PID effort changes the plant, and only plant state becomes /joint_states. The equations, numerical constants, limitations, and ROS interfaces are explicit, so future encoder data can replace nominal assumptions without changing the surrounding command stack.
