marcotayar/manipulator_ws/docs/full_arm_wiring.html

# ESP32 Full Arm Electrical Diagram

Two TB6612FNG drivers, three DC servo motors with potentiometer feedback, base servo, and gripper servo.

Power off before rewiring. Motor supply VM does not come from the ESP32. All grounds must be common. No ESP32 input may exceed 3.3 V.

control signal potentiometer feedback power common ground

## Power distribution

Connection | Connect to | Important
TB6612 #1 and #2 VCC | ESP32 3V3 | Logic power only; do not connect VCC to 5 V.
TB6612 #1 and #2 VM | External motor supply positive | Use a supply appropriate for the motors and their stall current.
Base/gripper servo power | External regulated servo supply | Do not power the motors or servos from the ESP32 3V3 pin.
Potentiometer reference | Each pot end terminal to regulated +5 V and common GND | Wipers connect directly to their calibrated ADC pins; mechanical travel must keep every wiper below 3.3 V.
All GND connections | ESP32 GND + both TB6612 GND + external supply negative + servo grounds + potentiometer grounds | A common reference is mandatory.

## Potentiometer feedback

Each potentiometer uses all three terminals: one end to a regulated +5 V reference, the other end to common GND, and the center wiper directly to the assigned calibrated ADC input.

Joint | ADC input | Connection | Calibration
Shoulder | GPIO34 | Center wiper directly to GPIO34 | Use only the captured GPIO34 table for the current wiring.
Elbow | GPIO39 / VN | Center wiper directly to GPIO39 | Use only the captured GPIO39 table for the current wiring.
Wrist | GPIO36 / VP | Center wiper directly to GPIO36 | Use only the captured GPIO36 table for the current wiring.

There is no resistor divider in the current build. The potentiometers use 5 V references, and the mechanical joint limits keep the calibrated wiper range below 3.3 V. This provides no electrical overvoltage protection if a mechanical stop, ground, or wiper connection fails. Never apply 5 V directly to an ESP32 ADC pin.

Commissioning order: keep motor power disconnected, verify common ground, measure each ADC node with a multimeter through the full mechanical range, confirm it never exceeds 3.3 V, then run the calibration firmware. Support the arm mechanically throughout calibration.

Boot warning: GPIO5 and GPIO15 are ESP32 strapping pins. If the board fails to boot with the drivers attached, disconnect those inputs during reset or revise the wiring and firmware together.
