marcotayar/manipulator_ws/full_arm_controller/shoulder_calibration_capture.csv

step | angle_deg | direction | adc_pin | raw_median | raw_min | raw_max | accepted_samples
1 | 75 | ascending | 34 | 1639 | 1635 | 1646 | 18
2 | 90 | ascending | 34 | 2057 | 2050 | 2067 | 18
3 | 105 | ascending | 34 | 2438 | 2430 | 2444 | 18
4 | 120 | ascending | 34 | 2762 | 2741 | 2773 | 18
5 | 135 | ascending | 34 | 3000 | 2995 | 3009 | 18
6 | 150 | ascending | 34 | 3157 | 3150 | 3181 | 14
7 | 165 | ascending | 34 | 3501 | 3491 | 3511 | 17
8 | 180 | ascending | 34 | 3892 | 3881 | 3908 | 17
9 | 165 | descending | 34 | 3484 | 3480 | 3490 | 10
10 | 150 | descending | 34 | 3162 | 3154 | 3170 | 18
11 | 135 | descending | 34 | 2894 | 2873 | 2903 | 18
12 | 120 | descending | 34 | 2612 | 2608 | 2619 | 18
13 | 105 | descending | 34 | 2373 | 2363 | 2376 | 18
14 | 90 | descending | 34 | 1993 | 1982 | 2001 | 18
15 | 175 | ascending_check | 34 | 3718 | 3712 | 3724 | 18
16 | 85 | descending_check | 34 | 1842 | 1838 | 1849 | 18
