marcotayar/manipulator_ws/full_arm_controller/wifi_config.example.h

#pragma once

// Copy to wifi_config.h and fill in local network settings. Do not commit secrets.
#define WIFI_SSID "YOUR_WIFI_SSID"
#define WIFI_PASS "YOUR_WIFI_PASSWORD"
#define AGENT_IP "192.168.1.100"
#define AGENT_PORT 8888
