marcotayar/manipulator_ws/(commit log)

2026-06-18 Initial commit: RRRR manipulator ROS 2 workspace
    - manipulator_description: URDF/xacro with corrected geometry (L1=0.10, L2=0.09, L3=0.16)
    - manipulator_control: keyboard teleop, click-to-target, arm_commander, base_vel_gui
    - manipulator_kinematics: geometric IK node with TF trajectory visualization
    - esp32_microros.ino: micro-ROS servo controller with reconnect watchdog
    - README with full build, usage, and hardware launch instructions
    [manipulator.urdf.xacro]
2026-06-18 Comm fix and IK fix, controller add
    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
    [esp32_microros.ino]
2026-06-19 failsafe add and IK fix
    [esp32_microros.ino]
2026-09-01 Support positional gripper control
2026-09-14 Fix Qt panel publishing, unify IK, wire base and gripper to sim
    The Qt panel silently published nothing: _send_target() early-returns when
    arm_ik_2d rejects the target, and its own default came from the safe start
    pose, which sits exactly on SH_MAX and WR_MIN. Strict limit comparisons
    rejected that pose on float error, and since the tip is on the workspace
    boundary the 3-decimal spinbox snap fell outside it as well.
    arm_ik_2d:
    - _in_limits() with LIMIT_EPS tolerance, so boundary poses stay solvable;
    accepted angles are clamped to the hard limits, keeping the epsilon a
    comparison tolerance that never widens the commanded servo range.
    - nearest_feasible() snaps a target to the clo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
2026-09-14 Add closed-loop PID simulation and mathematical model
2026-10-20 Add calibrated shoulder PID control and graphical tuning
2026-11-09 Add full-arm wiring calibration firmware
2026-11-09 Add full-arm wiring diagram
2026-11-09 Add full-arm wiring page and elbow/wrist calibration data
2026-11-09 Add calibrated full-arm PID controller with base and gripper servos
2026-11-09 Fix shoulder motor direction, gains, and control timeout from hardware test
2026-11-09 Remap joints to verified wiring, run control in dedicated task, hold integral in deadband
2026-11-09 Add setpoint ramp with lag limit, direction-based runaway, and stall cutout
2026-11-09 Limit targets to angles where friction holds the arm after a fault
2026-11-09 Short-brake motors on disable and faults instead of coasting
2026-11-09 Runaway requires the joint to be more than 4 deg from its setpoint
2026-11-09 Pots on ESP32 3V3: rescale calibration tables; confirmed two-sample target-relative runaway
2026-11-09 Pause motor PWM while sampling potentiometers (switching noise shifted readings)
2026-11-13 Calibrate replacement elbow and correct motor mapping
2026-11-13 Calibrate replacement shoulder feedback
2026-11-13 Calibrate replacement wrist feedback
2026-11-13 Refine joint calibration at 165 degrees
2026-11-13 Gravity defaults from powered holds: shoulder 33, elbow 28, wrist 25; shoulder Kp 3 Ki 2 Kd 0.1
2026-11-13 Per-joint runaway target distance: shoulder/elbow 6 deg, wrist 10 deg (stick-slip and backlash near target)
2026-11-13 Ignore Arduino IDE debug artifacts
2026-11-13 Replace Qt panel with full_arm_controller tuning + IK panel; physical-frame kinematics
